parkourlrc/pcb-yvoronkin--FailDeadly-78efd3bd12/firmware/Inc/stm32_assert.h

#ifndef STM32_ASSERT_H
#define STM32_ASSERT_H

#ifdef __cplusplus
extern "C" {
#endif

#include <stdint.h>

#ifdef USE_FULL_ASSERT

#ifndef assert_param

#define assert_param(expr) \
    ((expr) ? (void)0U : app_assert_failed((uint8_t *)__FILE__, __LINE__)) 

#endif /* assert_param */

void assert_storage_reset(void);
void assert_failed(uint8_t *file, uint32_t line);
void app_assert_failed(uint8_t *file, uint32_t line);

#else

#ifndef assert_param
#define assert_param(expr) ((void)0U)
#endif /* assert_param */

#endif /* USE_FULL_ASSERT */

#ifdef __cplusplus
}
#endif

#endif /* STM32_ASSERT_H */
