parkourlrc/pcb-yvoronkin--FailDeadly-78efd3bd12/(notices)

Notices in the files:
README.md:
Hardware license: CERN-OHL-S-2.0
Firmware license: GPL-2.0
